Milkmonkey/Gem-925-Sterling-Silver-Paper-Clips/README.md

# Gem 925 Sterling Silver Paper Clips

工程试制文件位于 [silver_clip_jig_v02](silver_clip_jig_v02/README.md)。包括参数化OpenSCAD工装、打印STL、三维成品参考、弯折动作图、专利/原型审查与中文实物测试计划。

先运行 `bash silver_clip_jig_v02/source/install_tools.sh` 准备Python工具；OpenSCAD CLI在当前云环境已提供。按子目录README重建和验证。无需后台服务。

当前状态：CAD名义成形路径和导出网格已经检查；全硬银的回弹、开裂和夹纸能力尚未实测。尤其B/C额外过弯空间有限，必须先做试样，不能直接批量裁切十根银线。
