Milkmonkey/Gem-925-Sterling-Silver-Paper-Clips/silver_clip_jig_v02/README.md

# 925 银 Gem 手动弯线工装 V0.2

这是**可打印的工程试制版**：采用一根活动成形轴、三个可换衬套、一支三规格压弯杆和三个夹块，按 **A→B→C** 换销、重新定位。CAD 中的理想弯折动作与实际导出的网格有检查记录；尚未打印，也没有对用户的全硬银丝做材料试验，因此不能称为已验证的银回形针生产设备。

先看 [尺寸图](reference/gem_clip_dimensions.png)、[弯折过程](renders/bending_sequence.png)、[装配图](renders/assembly.png)、[爆炸图](renders/exploded_view.png)。完整限制见 [验证报告](validation/REPORT.md)，材料及夹纸验收见 [TEST_PLAN.md](TEST_PLAN.md)。

## 设计结论

成品初始外形为 **29.00 × 8.00 mm**，线径 1.00 mm。四段平行直线、三段半圆构成经典 Gem 拓扑。内圈顶弧中心高度取 19 mm，顶面约 21.25 mm，低于外圈内侧；这是为了让最后装入的完整 Ø6 mm C 销避开先成形的内圈，不是从专利图量取的尺寸。内圈较普通长舌款短，夹纸性能必须实测。

三道中心线半径 A/B/C = **1.75 / 2.50 / 3.50 mm**，金属芯轴直径 = **2.5 / 4 / 6 mm**。B、C 超出最初 2–3 mm 优先范围，是几何和可购买标准光杆的折中；三根同径销不能得到这套轮廓。孔与芯轴尺寸相差 0.20 mm，必须先打印公差片，不能把此数值当作已校准的 FDM 配合。

理论中心线展开长 **92.347 mm**，估计净银重 **0.751 g/枚**。该展开长度假定中性层在圆截面中心，没有塑性伸长；初次铜丝可留约 1 mm 总修端余量，再测量修正。未经试样标定，不应直接剪好十根银丝。

**关键材料限制：** 全硬银的可用延性、屈服强度和回弹均未获得供应商证据。小半径弯曲的名义外纤维应变很高（A 约 28.6%、B 20.0%、C 14.3%，仅作几何风险指标，不能直接代替延伸率判据）。B、C 又有有限的平面过弯空间；实测需要的补偿若超过验证报告的几何上限，本方案就不能按现有规格直接用于该线材。此时应停止银丝试制，另行评估扩大成品、改变材料状态等方案；不能强压、重复反弯或悄悄以退火银替代全硬银。

## 文件与打印

| 文件 | 数量 / 用途 |
|---|---|
| `stl/base.stl` | 1，95 × 75 × 10 mm 底座 |
| `stl/bending_lever.stl` | 1，119 × 16 × 8 mm，一支杆有 A/B/C 三组孔 |
| `stl/additional_parts.stl` | 一盘 7 个独立实体：3 衬套、3 夹块、公差片 |
| `stl/liner_A/B/C.stl` | 单独补打；与整盘重复，勿重复备料 |
| `stl/clamp_A/B/C.stl` | 单独补打；已翻到大平面贴床的打印朝向 |
| `stl/tolerance_coupon.stl` | Ø3.00、3.10、3.15、3.20、3.25 mm 孔，厚 3 mm |
| `reference/gem_clip_reference.step / .stl` | 三维成品参考，**不是工具零件** |
| `reference/gem_clip_centerline_1to1.svg` | 8 × 29 mm 的 1:1 轮廓；打印禁用自动缩放 |
| `reference/setup_A/B/C.svg` | 各工序已成形段的定位辅助图，1:1 打印 |
| `source/` | OpenSCAD、统一参数 JSON、重建及校验程序 |

PETG、0.4 mm 喷嘴、0.2 mm 层高、5–6 圈壁、50–60% 填充为初始设置。底座及杆按 STL 底面平放；衬套大法兰贴床；夹块 STL 已倒置打印，装配时翻回，垫高的压线舌在上。沉头螺钉必须齐平。小横向 M3 底孔约 2.6 mm，短跨桥接，不承诺所有切片设置均能免支撑；先检查切片预览，必要时用手钻清孔，不改变中心距。

底座插孔底面的法兰座为短悬边，先用公差片和一个衬套检查打印质量。孔不得强行敲入银丝接触用钢销。杆上压弯销的径向 M3 孔需要手动攻丝；优先用紧定螺钉，过度拧紧会损坏 PETG 螺纹。轴承不是必需件，但所有金属接触面必须去毛刺、抛光。保护膜若改变了有效直径，必须重新标定半径。

## 装配

1. 将底座固定在约 150 × 150 × 12 mm 的平整牺牲木板上。四个角孔 Ø4.5 mm，可用 M4×30 螺钉、垫圈和螺母；木板再夹到工作台。底座底面应有支承，衬套靠板面托住。木板在夹持螺钉对应位置预留约 Ø8 × 2 mm 凹窝，避免 M4×16 螺钉顶住板面。
2. 从底面放入当前 A/B/C 衬套，法兰 Ø12 × 2，筒身 Ø8 × 8；装好后顶面与底座齐平。换衬套时松开底座，向下推出，不要用银丝撬。其余衬套留在收纳区，不留在运动区域。
3. 从底面装入夹块用 M4 螺母。当前夹块放在轴中心左 14、下 10 mm 的螺钉处，用 **M4×16 沉头螺钉**固定，薄的平滑保护垫只用于接触面，厚度变化要重新调夹持高度。夹块不是剪线器，先在铜丝上证明不会滑移或压扁。
4. 放入当前 Ø2.5/4/6 × 40 mm 的光滑金属芯轴。轴底靠木板、插入深约 10 mm。下端倒角、上端去毛刺，不能用钻头刃部接触银丝。
5. 芯轴上装**金属轴限位环/钻深限位环**，其最低面离底座顶面 1.50 mm，上表面离底座顶面 9.50 mm。图示按高 8 mm、轴心外包络直径不大于 14 mm 计算。实际较矮的限位环可在其上垫光滑金属垫圈到同一高度，不能在底下放穿过线材平面的宽垫圈。锁定并检查与银丝顶面至少 0.50 mm 净隙。
6. 杆的对应 A/B/C 大孔套在芯轴上，杆底落在限位环上，距底座顶面 9.50 mm。选择同字母小孔，插入一根 **Ø3 × 25 mm 抛光钢销**，下端距底座顶面 0.15 mm。用杆侧 M3 紧定螺钉锁住；**其余两根压弯销不装**。杆只转动，不应向下压住银丝或夹块。
7. 桌面留出轴心约 120 mm 半径的手柄扫掠空间。先空转，再放铜丝检查；台钳、尺子、未使用的销轴都要移出。打印件强度与钢销强度没有经过实物载荷验证，勿加长手柄或敲击加载。

限位环提供高度支承，金属主轴提供旋转定位，底座夹块固定直段；这三项都需要，不能照 V0.1 仅凭手悬住压弯杆。

## 从直线到成品：A→B→C

以下数值来自**修平后的起点 P0**，不是多留余量后的毛坯端：P1=12.000，P2=17.498，P3=33.498，P4=41.352，P5=63.352，P6=74.347，P7=92.347 mm。用细记号笔标记，不刻伤线材。起点是内侧自由端，最后形成的外侧自由端是 P7。

三次操作均将当前**入弯直段从轴心下方向上送入，位于轴心左侧 R mm**；压弯销起于左侧，杆从左向上、向右**顺时针**转动。轴不是三道弯的空间坐标：每次要搬移、转向工件，让相应的 P1/P3/P5 对准同一根工作轴。

| 工序 | 装轴 / 夹块 / 杆孔 | 定位与固定 | 旋转及退件 |
|---|---|---|---|
| A | Ø2.5 / A / A | P1 到轴心水平线，入线中心 X=轴心−1.75；P0 在其下 12 mm；夹住下方直段。其余约 80 mm 为可动余料。 | 顺时针弯成顶部小 U。名义线材弯 180°；杆需加上约 13.09° 的接触空程，再加**实测允许**的回弹补偿。先拔压弯销、抬杆，松夹块，再整体向上拔出主轴和限位环，拿出工件。 |
| B | Ø4 / B / B | 将 A 工件转 180°；P3 对准轴心水平线，入线中心 X=轴心−2.50；夹住 A 后的 16 mm 直段中部，已弯 A 在轴心下方。 | 顺时针形成底部 U；杆名义约 191.97°。上一道 A 销已不在场；不得为了保持形状把它留在工件里。释放次序同 A。 |
| C | Ø6 / C / C | 工件恢复成品图方向；P5 对准轴心水平线，入线中心 X=轴心−3.50；夹住 22 mm 外侧直段。A、B 全部在工作轴下方，内圈顶端避开 C 销。 | 顺时针形成外圈顶弧；杆名义约 190.84°。最后外侧 18 mm 向右折下，压弯销在成品外侧。先向上拔压弯销和杆，再松夹块、拔 C 轴，成品可垂直抬走，无需掰开银丝。 |

表内杆角为理想无摩擦接触几何估计，包含 0.10 mm 径向游隙的几何接触空程，**不等于材料回弹补偿**。没有机械止挡，首次用纸质量角器和记号线逐步校准，不能只按杆角判定成品角度。`springback_compensation=0` 是尚未标定的初始值，不代表全硬银没有回弹。

每步都检查已弯部分没有被夹块碰到、当前销能拔出。过弯可导致自碰，尤其 B、C；见验证报告的实测采样界限并预留裕量。若银丝回弹无法在界限内补偿，停止该规格试制，不能将线段强行交叉或叠层后宣称合格。

## 校验与夹纸

底座右侧刻线只有测量用途，不参与承力，也不是卡死成品的凹模。标线内侧参考跨度为 29 与 8 mm，0.15 mm 线宽本身不作为精密量具；最终用游标卡尺测量。成品图起点、终点位于同一 Y=7 mm，三维参考初始共面。插纸时让内舌位于纸束一面、外圈位于另一面；仅把整枚金属线平放在纸上不会夹持。

本版没有擅自加入未验证的交叉、锤击或预扭。静态共面模型只能给出轮廓；接触预载与薄纸夹持需要实测。如 2 张纸即滑落，应记录并单独设计预载/空间微调，而不是凭图宣称功能成功。

## 重建与验证

在仓库根目录执行 `bash silver_clip_jig_v02/source/install_tools.sh`。环境已经安装 OpenSCAD 2021.01，安装脚本只准备 Python 工具；CAD/渲染依赖版本见 `source/requirements.txt`。

```bash
cd /workspace/Gem-925-Sterling-Silver-Paper-Clips/silver_clip_jig_v02
export XDG_CACHE_HOME=/tmp/silver-clip-cache
export MPLCONFIGDIR=/tmp/silver-clip-matplotlib
/workspace/.venvs/silver-clip/bin/python source/build.py
/workspace/.venvs/silver-clip/bin/python source/validate.py
/workspace/.venvs/silver-clip/bin/python source/design_review.py
```

默认参数入口为 `source/parameters.json`，重建先生成 `parameters.scad`，再调用 OpenSCAD 真正导出 STL；直接在 OpenSCAD 打开也可按 `part` 导出。JSON 改动不会自动重建。修改半径、线径、尺寸、芯轴/限位环高度后必须重新检查；SVG 定位图和 STL 也要一起重建。不要把多实体 `additional_parts.stl` 的 7 个零件当作一件粘合打印。

原型与专利资料存于 `reference/`，其审查见 [DESIGN_REVIEW.md](DESIGN_REVIEW.md)。设计目标成本、工装成本分列在 [BOM.md](BOM.md)，不声称当前银价已满足每枚 3 美元。
