Milkmonkey/Gem-925-Sterling-Silver-Paper-Clips/silver_clip_jig_v02/DESIGN_REVIEW.md

# 原型、专利与机构审查

## 已读资料

用户提供的 `silver_clip_jig_v01.zip` 已逐项解压并读取SCAD、STL、预览和装配说明，原样副本保存在 `reference/v01/`。专利网页为 https://patents.google.com/patent/US636272A/en ，原始PDF来自 https://patentimages.storage.googleapis.com/f8/2f/f3/f1428de641b1ff/US636272.pdf ，均实际下载；`reference/US636272.pdf` 和 `US636272-sheet2.png` 可离线查阅。正文文本也保存为 `US636272_text.txt`，其中OCR可能误把C识别为O，仍以扫描附图为准。

专利为William D. Middlebrook，US636272A，1899-11-07。已目视检查第二张图纸的Fig.5–8并对照说明书的工作过程，而非只参考搜索摘要。图不是比例尺寸图，本版半径均未从图中量取。

## Fig.5–8 的实际动作

| 附图 | 原机动作 | 对手动工装的启示 |
|---|---|---|
| Fig.5 | 线X经校直/送线、夹持及切断装置进入；夹杆36将线固定在C侧，A、B、C沿送线方向布置。上下面板F/D之间的窄缝约束线材平面；C销一侧有切除/凹槽，不是完整圆柱。 | 必须有独立夹持和明确的高度栈，不能只画三根柱。完整圆销C的包络要另外检查。 |
| Fig.6 | 齿条40驱动A弯绕器转动，偏置弯绕凸部绕中心销a形成第一弯。之后A下撤至面板D或以下，使已弯部分可进入下一动作。 | A成形后必须退出运动区域；人工拔销对应撤轴原理。 |
| Fig.7 | 齿条43驱动B弯绕凸部形成第二弯，随后凸部先下撤，中心销b短暂保留定位；中心销又由杆52上抽，杆48等机构对局部作永久定形。 | 旋转压弯件和中心定位销的退出是不同动作；不能把销留在闭合后的环里等最终硬拔。局部定形意味着原机也不是纯几何绕180°即可完成。 |
| Fig.8 | 滑台上的成形钳45/46绕C完成最后折弯，夹杆36仍保持线。末段由凸轮作用进一步压定；C随后下撤，钩57/滑块58带出成品，从床身孔59落下。 | 最终C处既要有保持，也要有退出路径。手动版用上拔金属销后整体提走，不能靠强行撑开成品。 |

原机的A/B转动、分时上下撤销、成形钳与辅助压定机构共同工作；不能认为原机已经验证了本版全硬925银的延性、回弹或夹持力。手动版采用分步搬移和同轴换销，也没有复制原机自动定形钳。

## V0.1 检查

两个原STL都是单个封闭网格，实测包络分别为42×80×8和65×15×9 mm；没有把“网格坏了”作为推翻原型的理由。问题在工艺与几何：

1. `station_pitch=18` 与29×8成品无推导关系，没有完整中心线路径与展开长度。
2. 三根Ø3销只能给约R2中心线半径，不能同时给本版三种所需圆弧。
3. 无明确的当前入线切点、夹持位置、送料坐标或初始长度；已弯部分如何避让不明确。
4. 原说明要求手悬杆于底座上方，缺少可靠高度支承；压弯销也没有明确轴向锁定。
5. 金属主销虽可拔，但没有给出每一步拔哪些销、先拔哪一个、最后怎么脱模的完整动作。
6. 没有成形阶段扫掠、全硬银最小半径/回弹数据、夹纸试验；文件自身也明确称为未经验证概念。

## V0.2 的取舍和被淘汰方案

本版将固定三工位改为**单轴换销**，每次仅一根金属主轴和一根金属压弯销存在；A/B/C是工序名及规格名，不是照搬18 mm空间间距。孔位、夹块和杆的接触距由目标中心线半径推得，夹持与上方限位环分担定位和高度保持。

初期尝试将A内圈顶弧靠近外圈顶部：完整Ø6 C销会占据已弯内圈。于是将A中心下移至Y=19 mm；现有理想模型中C销与既有线材净隙约0.755 mm。代价是内舌较短，功能是否合适待实测。

另试C→B→A，期望把最后小弯放在开放内区。实际中心线扫掠发现：先成形的C上弯挡住尚未成形的长余料，B在约146.25°首次出现**线材表面**接触，随后约156°出现中心线穿越；不能采用。`source/design_review.py` 可重复得到这一拒绝结果。后续A阶段仅是假设前序能完成的反例，没有把它统计为可执行工艺。

交付顺序A→B→C在理想无回弹0–180°过程可完成；最后C的杆与压弯销在成品外侧、所有宽支承位于线上方，拔压弯销→抬杆→松夹→拔主轴即可脱模。未用隐含“轴自动穿过银丝”解决干涉。

**仍未解决的材料相关限制是有限过弯空间。** A/B/C额外过弯的首次采样碰撞分别约11.85/1.80/3.25°。本版因此是铜丝动作及银丝半径试制工装，不是已经保证适配任意全硬925银的最终生产方案。完整银件试制以前，必须实测材料需求小于允许空间并留裕量；超出就应判该线材/几何组合NO-GO。未设计或宣称未经验证的自动出平面、加热退火、反复反弯可以解决它。

## 基本载荷估计的边界

取一个**假设**压弯/上轴承反力40 N、上轴承反力高度13.5 mm，将Ø2.5钢轴粗略当悬臂，弯曲正应力约352 MPa；假设钢E=200 GPa时挠度约0.086 mm。杆最窄腹板约0.94×8 mm，单纯平均剪应力约5.32 MPa；这不能代表孔边应力集中、层间性能或整体强度安全系数。

40 N不是已测银丝需求，也不是允许工作载荷。此估计说明应采用硬钢光杆、限制杆挠曲、避免宽松孔和蠕变，而不能宣称“PETG和任意廉价销足够强”。实际供销材料、打印层结合、夹持摩擦、限位环滑移均待验证，没有运行FEA或疲劳仿真。
