Milkmonkey/Gem-925-Sterling-Silver-Paper-Clips/silver_clip_jig_v02/validation/REPORT.md

# V0.2 验证记录

本报告针对交付的默认参数；原始机器可读结果见 `results.json`、`reference_brep.json`、`design_review.json` 和各个 `openscad_*.log`。参数修改后须重新运行程序并更新报告，不能把本次通过状态继承到新参数。

## 实际完成并通过的检查

| 检查 | 工具及证据 | 结果 |
|---|---|---|
| 专利正文与Fig.5–8 | HTTPS下载原PDF、HTML文本，目视第二张扫描图 | 已阅读；尺寸未照抄图片 |
| V0.1源文件与网格 | 实读SCAD/说明、Trimesh检查2个STL | 均封闭，尺寸42×80×8 / 65×15×9；缺口在机构与工艺 |
| 最终中心线路径 | 7个相切几何段、连续性断言、非相邻距离、Shapely无自交检查 | 连续、无自交，包络8×29 mm |
| 展开长度 | 解析直线+圆弧，对照1°采样弧长 | 92.347343 mm；采样92.347034，差0.000309 mm |
| 三维参考实体 | CadQuery 2.7.0 / OpenCascade 精确圆截面扫掠 | 有效BRep、单实体；另导出STEP和STL |
| 可打印零件实际导出 | OpenSCAD 2021.01 CLI，保存真实退出码和日志 | 10个工具STL导出成功，未忽略错误/警告 |
| STL闭合性 | Trimesh：watertight、绕序一致、正体积、逐实体检查 | 10个工具文件及1个参考STL通过；附加件盘7个独立实体，其余每文件1实体 |
| 实际孔位 | 从STL实取Z截面并测孔包络 | 底座主孔/夹持孔、杆6孔、衬套3内孔符合中心位置和孔径，约0.01 mm计算容差 |
| 打印朝向 | 检查每个独立实体最低Z=0 | 均落床；夹块大平面翻向打印床 |
| 名义成形动作 | A/B/C各0–180°，0.25°步长、每道721姿态 | 理想模型未发现已有线与活动圆弧/余料、固定线与压弯销、其它线与夹块、压弯销与夹块的碰撞 |
| 完整圆主销插入 | 当前芯轴圆包络与已成形路径距离 | B约1.623 mm，C约0.755 mm净隙；当前入线接触是预期约束 |
| 高度避让 | 线材顶1、限位环底1.5、杆底9.5、夹块顶5，均相对底座顶面 | 名义高度分离，主轴贯穿杆孔有足够长度；实际装配必须复核 |
| 反序方案反例 | `design_review.py` 另算C→B→A | B约146.25°开始线材表面碰撞；拒绝此方案 |
| 重复安装 | 再次执行 `install_tools.sh` | 固定版本依赖满足，实际CAD/网格/绘图库导入成功 |
| 图像输出 | Matplotlib Agg +真实三角面软件深度缓冲 | 尺寸、装配、爆炸与过程PNG实际生成；无需X服务 |

“11个STL文件”包含一盘附加件及其单独补打版本，不是11个不同工具零件。实际打印：底座1、杆1、衬套3、夹块3、公差片1，共9件。

## 名义动作的最小净隙

| 项目 | A | B | C |
|---|---:|---:|---:|
| 先成形线–活动余料表面 | 无先成形段 | 0.500 mm | 1.000 mm |
| 固定线–压弯销表面 | 0.182 mm | 0.216 mm | 0.261 mm |
| 其它线–夹块表面 | 2.350 mm | 2.350 mm | **0.350 mm** |
| 压弯销–夹块 | 7.509 mm | 7.519 mm | 7.500 mm |

压弯销与当前可动直尾的切触、芯轴与当前弯段的切触、夹块压在目标线材上都是有意接触，不按碰撞处理。0.35 mm间隙容易受FDM误差影响，实际打印必须量测；数值不是制造安全裕量。

## 过弯空间：未解决的工艺约束

在每道既有弯已理想成形为180°的前提下，以0.05°步长追加当前弯角，计算线材直径后的第一次自碰或夹具碰撞：

| 道次 | 最后一个未碰撞采样 | 第一个碰撞采样 |
|---|---:|---:|
| A | 11.80° | 11.85° |
| B | 1.75° | 1.80° |
| C | 3.20° | 3.25° |

这里保留的是**过弯角**；杆还有A13.09/B11.97/C10.84°接触空程。严禁混用两者。报告不把最后安全采样当作允许工作值，应预留实际线材、孔位、角度误差裕量。对全硬银，B/C可补偿量可能不足，因此不能宣称材料路线已验证。实测超过允许空间即NO-GO，具体顺序见 `TEST_PLAN.md`。

末步脱模是按高度分离与可拔销结构检查的运动方案：先向上拔Ø3压弯销，再抬杆、松夹块，最后向上抽出带限位环的C主轴，取出没有封闭扣环的开放线形。没有进行手接触、摩擦、拔出力或塑料孔夹紧的仿真，仍必须用铜丝实际确认。

## 强度与打印检查的范围

仅做基本数量级估计：假设40 N反力、13.5 mm钢轴悬臂高度，Ø2.5轴约352 MPa弯曲应力、0.086 mm挠度；最窄杆腹板的简单平均剪应力约5.32 MPa。这不是FEA、额定载荷、疲劳验证或PETG层间强度证明，硬件材质与实际需求未知。

零件按大平面落床设计；夹块已倒置避免鼻端底部悬空。底座底面衬套座的约2 mm局部悬边、小直径M3横孔，以及低于0.4 mm的浅刻细线仍需切片检查/必要清孔。没有安装切片器或打印机，未生成G-code，也未声称实体打印免支撑通过。精密定位用卡尺及1:1辅助图，不依赖喷嘴无法解析的细刻线。

初始图形渲染曾遇到VTK的X服务依赖失败，已替换为无X的CPU软件深度缓冲并实际生成成品图像；当前重建流程不依赖该失败路径。OpenSCAD导出仍使用真实CGAL实体运算，没有以图片或空文件替代STL。

## 待实体测试，不能宣称通过

银丝延性与表面裂纹、塑性中性层/真实下料长度、卸载半径与回弹、夹块摩擦/滑移、打印杆和限位环载荷能力、孔径制造误差、手动定位精度、2/5/10张夹纸及30次循环保持力、实际单枚成本。

扫掠为离散理想中心线计算，不是连续解析碰撞证明或全机构接触有限元。实际主轴间隙、材料横截面椭圆化、摩擦、出平面变形、人的操作误差均未模拟。判断“可试制”和“满足全硬银成品功能”必须分开。
