Milkmonkey/Gem-925-Sterling-Silver-Paper-Clips/silver_clip_jig_v02/reference/USER_BRIEF_zh.md

# Codex 工程任务：925 银 Gem 回形针手动成形模具 V0.2

## 一、项目背景与目标

我计划以低成本自行制作 10 枚经典 Gem 双圆弧回形针。

成品使用直径 1.0 mm 的全硬态 925 银圆线，外形参考普通 3# Gem 回形针。

由于数量过少，不考虑工业冲压、数控加工或金属激光切割。我希望利用家用 FDM 3D 打印机制作一套可重复使用的手动弯线模具。

此前已经制作了 V0.1 概念模型，但该模型只是初步结构探索，没有完成成品几何尺寸校准，也没有验证实际成形过程。

**本次任务不是简单修改原有模型，而是重新审查其机构合理性，完成具有实际可操作性的 V0.2 工程设计。**

## 二、参考资料

### 1. 历史专利

William D. Middlebrook：

*Machine for Making Wire Paper-Clips*

美国专利 US636272A，1899 年。

https://patents.google.com/patent/US636272A/en

重点分析专利 Fig.5、Fig.6、Fig.7、Fig.8。

这些图展示了金属丝在不同工位经过连续弯折形成 Gem 回形针的过程。

请阅读专利附图和文字描述，理解其中的：

- 弯折轴 A、B、C 的相对运动
- 绕线方向和弯折顺序
- 金属丝的定位与夹持
- 弯折轴的退出方式
- 不同阶段已经成形部分的避让
- 最终回形针如何从机构中脱离

不要求忠实复制整台自动化机器，而是提取适合手动操作的核心机械原理。

### 2. 现有文件

检查提供的 `silver_clip_jig_v01.zip`，其中包含：

- `silver_clip_jig_v01.scad`
- `silver_clip_base_v01.stl`
- `silver_clip_lever_v01.stl`
- `silver_clip_jig_preview.png`
- `README_assembly.txt`

将其作为参考原型，而不是正确的最终设计。

特别注意：

V0.1 中的 `station_pitch = 18` 只是未经验证的临时参数，不能直接认为适合 29 mm Gem 回形针。

必须重新建立成品几何和模具定位关系。

## 三、最终成品规格

| 参数 | 目标 |
|---|---|
| 造型 | 经典 Gem 双圆弧回形针 |
| 外形长度 | 约 29 mm |
| 外形宽度 | 约 8 mm |
| 线材 | 925 Sterling Silver |
| 线径 | 1.00 mm |
| 线材状态 | Full Hard，全硬态 |
| 数量 | 10 枚 |
| 单枚目标成本 | 不超过 3 美元 |

尺寸作为初步设计目标，可以根据真实 Gem 几何、金属丝截面和圆弧半径进行小幅调整，但必须说明调整原因。

最终产品需要具备实际夹纸功能，而不是仅用于展示的金属丝模型。

## 四、首要任务：重新建立 Gem 几何

不要直接设计模具。

首先建立一枚正确的经典 Gem 回形针的二维中心线路径。

需要包含：

1. 外侧轮廓。
2. 内侧弹性夹持线段。
3. 所有圆弧的中心位置及半径。
4. 线材起点与终点。
5. 每条直线段的长度。
6. 银丝理论展开长度。
7. 内外线段之间的自然间隙。
8. 可能产生接触或干涉的位置。

整个几何模型必须参数化。

至少开放以下参数：

```text
clip_length = 29.0
clip_width = 8.0
wire_diameter = 1.0

bend_radius_A = adjustable
bend_radius_B = adjustable
bend_radius_C = adjustable

inner_gap = adjustable
springback_compensation = adjustable
```

弯曲半径不能直接照抄专利图片。图片不是完整的现代尺寸工程图。

根据目标尺寸、银丝直径及全硬银丝的成形限制，建立合理的初始几何。

如果缺乏足够数据，明确区分工程假设和已经验证的参数。

输出成品的二维尺寸图及三维参考模型。

## 五、第二任务：确定实际弯折顺序

这是整个项目最重要的部分。

不要只制作三根固定的圆柱。

必须模拟从一根直银丝开始，依次完成全部弯折的实际操作。

对每个步骤分别明确：

- 当前银丝的形状
- 哪个位置需要固定
- 哪个位置需要旋转或压弯
- 施力方向
- 弯折的目标角度
- 是否需要超过目标角度以补偿回弹
- 已形成的结构是否会与模具干涉
- 定位销是否需要暂时拔出
- 能否顺利进入下一道工序

尤其要检查最后一道弯折。

不能出现理论轮廓正确，但实际无法完成最后一次弯折或无法取出成品的情况。

优先考虑以下机构：

**可拆卸金属销轴 + 3D 打印底座 + 旋转压弯杆。**

如果发现三工位结构不合理，可以改为多个独立工位，或者增加一个辅助夹持机构。

允许改变 V0.1 的布局。

要求优先保证真实机械可行性，而不是外观上类似历史专利。

## 六、第三任务：设计 3D 打印模具

### 6.1 底座

初步考虑：

- 尺寸约 60–100 mm × 50–80 mm
- 厚度约 8–12 mm
- 平面放置
- 圆角处理
- 预留金属销轴插孔
- 标注 A、B、C 成形工位
- 必要时增加起始定位挡块
- 必要时增加金属丝的临时固定结构

尺寸可以根据实际机械布局优化。

### 6.2 金属定位销

优先采用直径 2–3 mm 的光滑金属圆销。

金属销用于直接接触和支撑银丝，避免 3D 打印的小型塑料柱承受过大的局部载荷。

应支持拆卸、更换，以及按实际打印误差调整装配孔径。

如果需要不同半径的弯曲轴，可以设计可更换的销轴方案。

### 6.3 旋转压弯杆

尽可能设计一支可重复使用的手动压弯工具。

要求：

- 可围绕定位销旋转
- 具有合理的手柄长度
- 压弯点与定位轴之间保留银丝通道
- 减少银丝表面被刮伤的概率
- 允许操作者控制弯折角度
- 避免施力后打印件发生明显扭曲或开裂

压弯工具与银丝直接接触的部位，优先使用光滑金属销或可更换的保护部件。

如果单一旋转杆无法完成所有工序，可以设计可换向、可调整或多规格压弯组件。

### 6.4 成品校验区

希望在底座增加一个简单的成品校验区。

包含：

- 29 mm 长度参考
- 8 mm 宽度参考
- Gem 中心线轮廓参考
- 检查成品是否明显变形的定位结构

校验区不应妨碍弯折机构工作。

## 七、材料力学约束

目标线材为：

**1 mm 全硬态 925 银圆线。**

可采用以下初步材料参数：

```text
Elastic modulus: approximately 82 GPa
Density: approximately 10.36 g/cm³
```

实际屈服强度、延伸率和加工硬化状态必须根据供应商资料确定。

考虑以下问题：

1. 全硬态银线的剩余塑性变形能力较低。
2. 过小的弯曲半径可能导致表面开裂。
3. 全硬银线具有弹性回弹。
4. 反复弯折同一位置可能导致损伤。
5. 银线抗弯刚度与钢丝不同，最终夹持力未必相同。

不要假定 1 mm 全硬银线一定能成功制成普通 Gem 回形针。

建模时把弯曲半径和回弹补偿设为可调参数。

对于无法通过静态几何确定的材料问题，标记为需要实测验证。

不要通过缺乏依据的材料假设，宣称模具已经经过力学验证。

## 八、打印与制造要求

优先兼容普通 FDM 3D 打印机。

建议初始制造条件：

```text
Nozzle: 0.4 mm
Layer height: 0.2 mm
Material: PETG
Walls: 4–6
Infill: 40–60%
```

所有零件必须尽可能免支撑打印。

涉及金属销配合的孔应提供可调整公差。

对于关键装配，设计小型孔径公差测试件也可以接受。

不要将承担主要弯折载荷的细长金属销改成 3D 打印塑料柱。

不要求使用昂贵的五金件、轴承、线性导轨或特殊加工。

整个机构应该能够使用普通 3D 打印件、廉价标准圆销和简单手工具完成组装。

## 九、输出文件

优先使用 OpenSCAD 进行参数化设计，也可以使用 CadQuery，但必须提供可重新生成模型的源文件。

输出目录：

`silver_clip_jig_v02/`

至少包含：

```text
silver_clip_jig_v02/
├── source/
│   ├── silver_clip_jig_v02.scad
│   └── parameters.md
│
├── stl/
│   ├── base.stl
│   ├── bending_lever.stl
│   └── additional_parts.stl
│
├── reference/
│   ├── gem_clip_reference.svg
│   └── gem_clip_dimensions.png
│
├── renders/
│   ├── assembly.png
│   ├── exploded_view.png
│   └── bending_sequence.png
│
├── README.md
├── BOM.md
└── TEST_PLAN.md
```

如果实际设计不需要额外零件，可以省略 `additional_parts.stl`。

`bending_sequence.png` 应尽可能清楚地展示各个折弯阶段，也可以分成多张图片。

`README.md` 必须用中文编写。

物料清单至少注明各定位销规格、数量、建议长度，以及其他必要紧固件。

## 十、验证和验收

请在交付前完成以下检查：

### 几何检查

- 完整 Gem 轮廓是否在目标尺寸范围内
- 金属丝路径是否连续
- 是否存在不合理的线材自相交
- 是否准确计算展开长度
- 模具成形轴位置与目标回形针几何是否一致

### 机构检查

- 每一道弯折是否有合理的施力路径
- 旋转工具是否与其他定位销碰撞
- 已弯制的银丝是否阻碍后续操作
- 定位销能否在需要时移除
- 成品能否顺利脱模

### 模型检查

- 每个 STL 是否为封闭实体
- 是否有非流形几何
- 是否存在明显悬空或不可打印结构
- 重要孔位和装配间隙是否合理
- 模具结构是否具有足够的基本强度

如果可以运行 OpenSCAD CLI，请实际导出 STL，并检查是否成功。

如有合适的渲染或几何检查工具，实际执行检查，不要仅口头声称通过。

### 实物测试计划

需要提供一个明确的测试顺序：

1. 使用 1 mm 铜丝验证弯折动作和工装几何。
2. 使用少量全硬 925 银线进行弯曲半径测试。
3. 制作第一枚完整银回形针。
4. 测量成品长度、宽度与实际展开长度。
5. 进行 2、5、10 张纸的夹持测试。
6. 重复夹取 30 次，检查回弹、裂纹和永久变形。
7. 根据测试结果调整模型，再制作剩余九枚。

必须明确指出：铜丝能够验证成形动作，但不能替代银丝的力学性能测试。

## 十一、成本原则

最终目标为十枚实心 925 银回形针。

单枚成品目标成本不超过 3 美元。

3D 打印模具为可重复使用的工具，材料成本与模具制作成本分别统计。

尽可能减少银丝损耗。

不采用贵金属激光切割、银板加工、失蜡铸造等昂贵路线。

优先使用普通 FDM 打印技术和标准廉价零件。

## 十二、执行方式

请不要停留在方案讨论，也不要只输出文字建议。

直接进行工程建模与迭代：

1. 检查现有 V0.1 文件及专利。
2. 指出原模型存在的实际问题。
3. 构建参数化 Gem 回形针参考模型。
4. 规划完整弯折顺序。
5. 设计 V0.2 模具。
6. 导出能够打印的 STL。
7. 生成装配与操作示意图。
8. 检查打印可行性与几何干涉。
9. 编写中文组装说明和测试计划。

如果发现当前机械方案存在根本性干涉或无法完成弯折，请主动修改结构，不必机械地沿用 V0.1。

优先交付结构简单、容易制作、能实际操作的方案，而不是外观复杂的概念模型。

最终明确区分：

- 已通过 CAD 或代码验证的内容
- 基于工程假设设计的内容
- 必须等待实体打印和银丝试制才能确定的内容

**最终目标：一套低成本、可真实打印、可装配、可操作，并能用于试制 29 mm 经典 Gem 银回形针的手动弯线工装。**
