Milkmonkey/Gem-925-Sterling-Silver-Paper-Clips/silver_clip_jig_v02/reference/gem_clip_dimensions.png

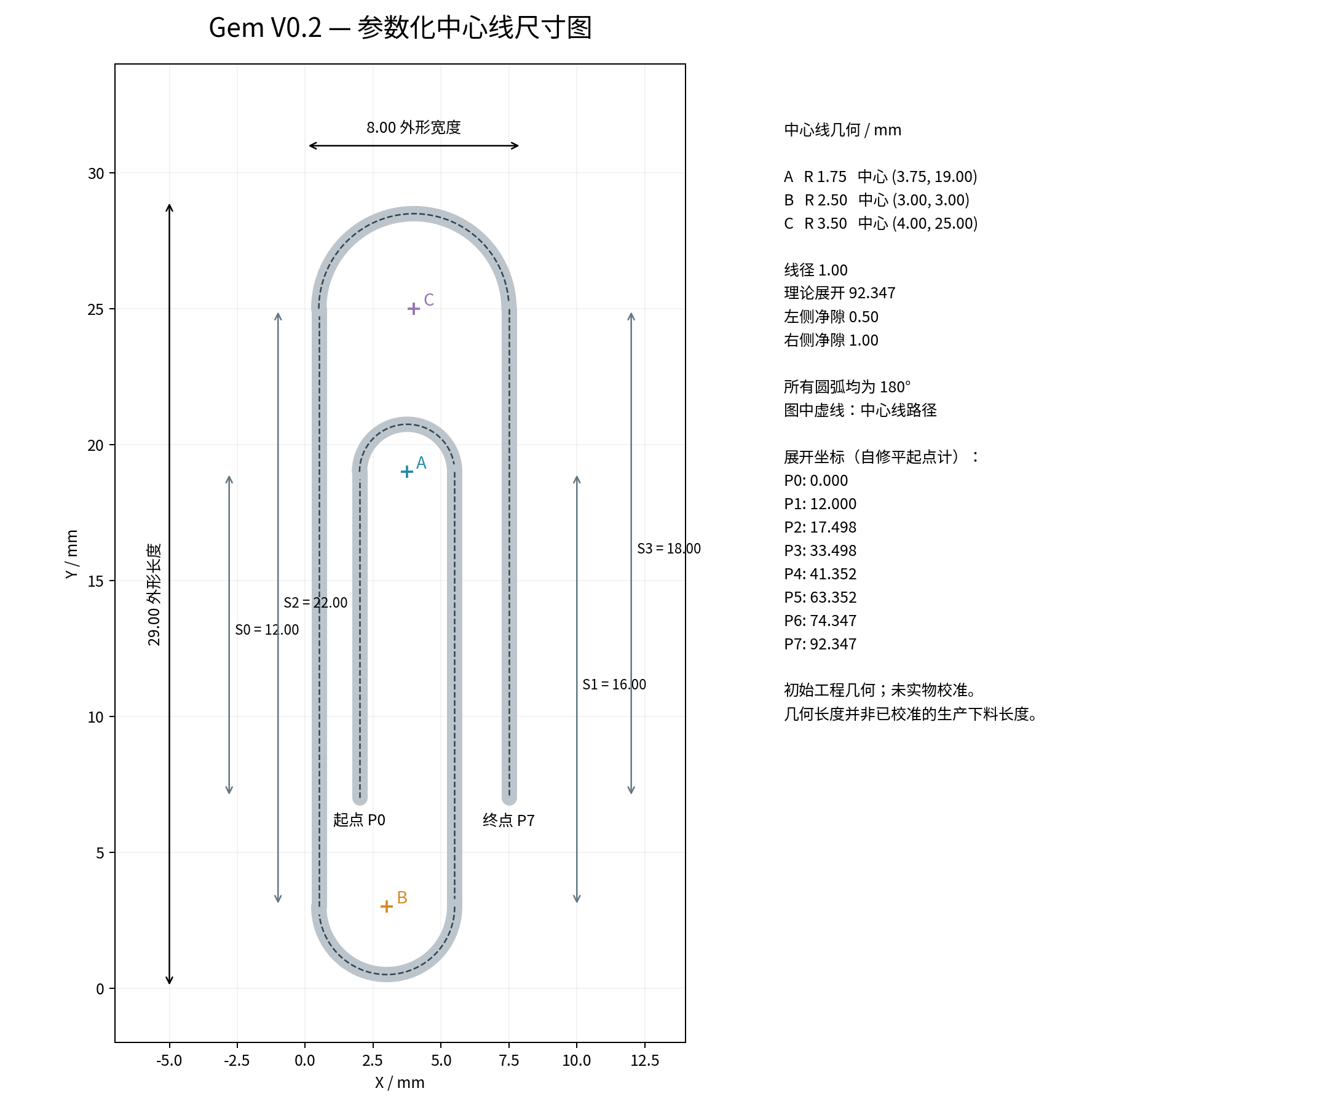
silver_clip_jig_v02/reference/gem_clip_dimensions.png
