Milkmonkey/Gem-925-Sterling-Silver-Paper-Clips/silver_clip_jig_v02/reference/US636272-figures5-8-inspection.png

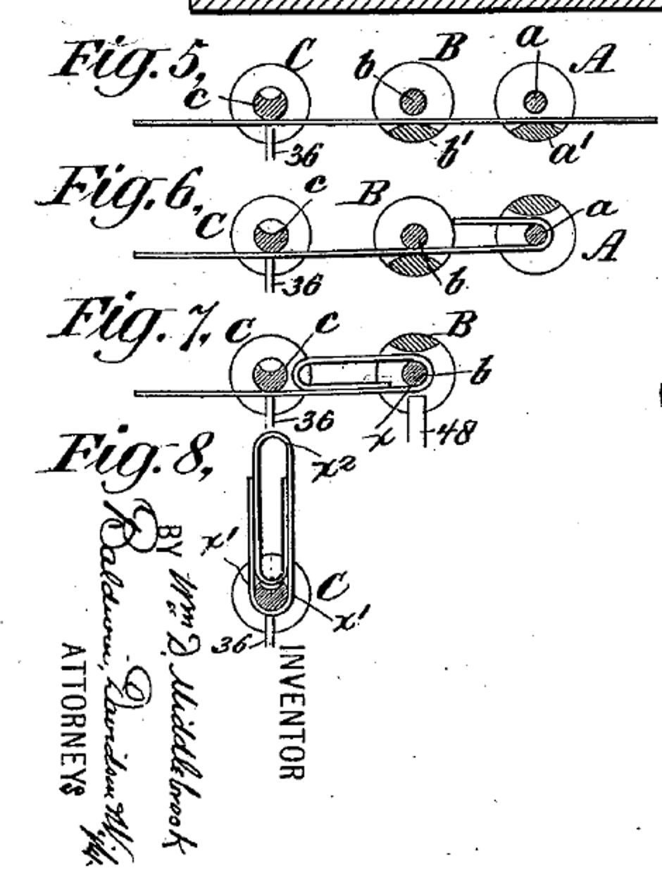
silver_clip_jig_v02/reference/US636272-figures5-8-inspection.png
