Milkmonkey/Gem-925-Sterling-Silver-Paper-Clips/silver_clip_jig_v02/reference/US636272-sheet2.png

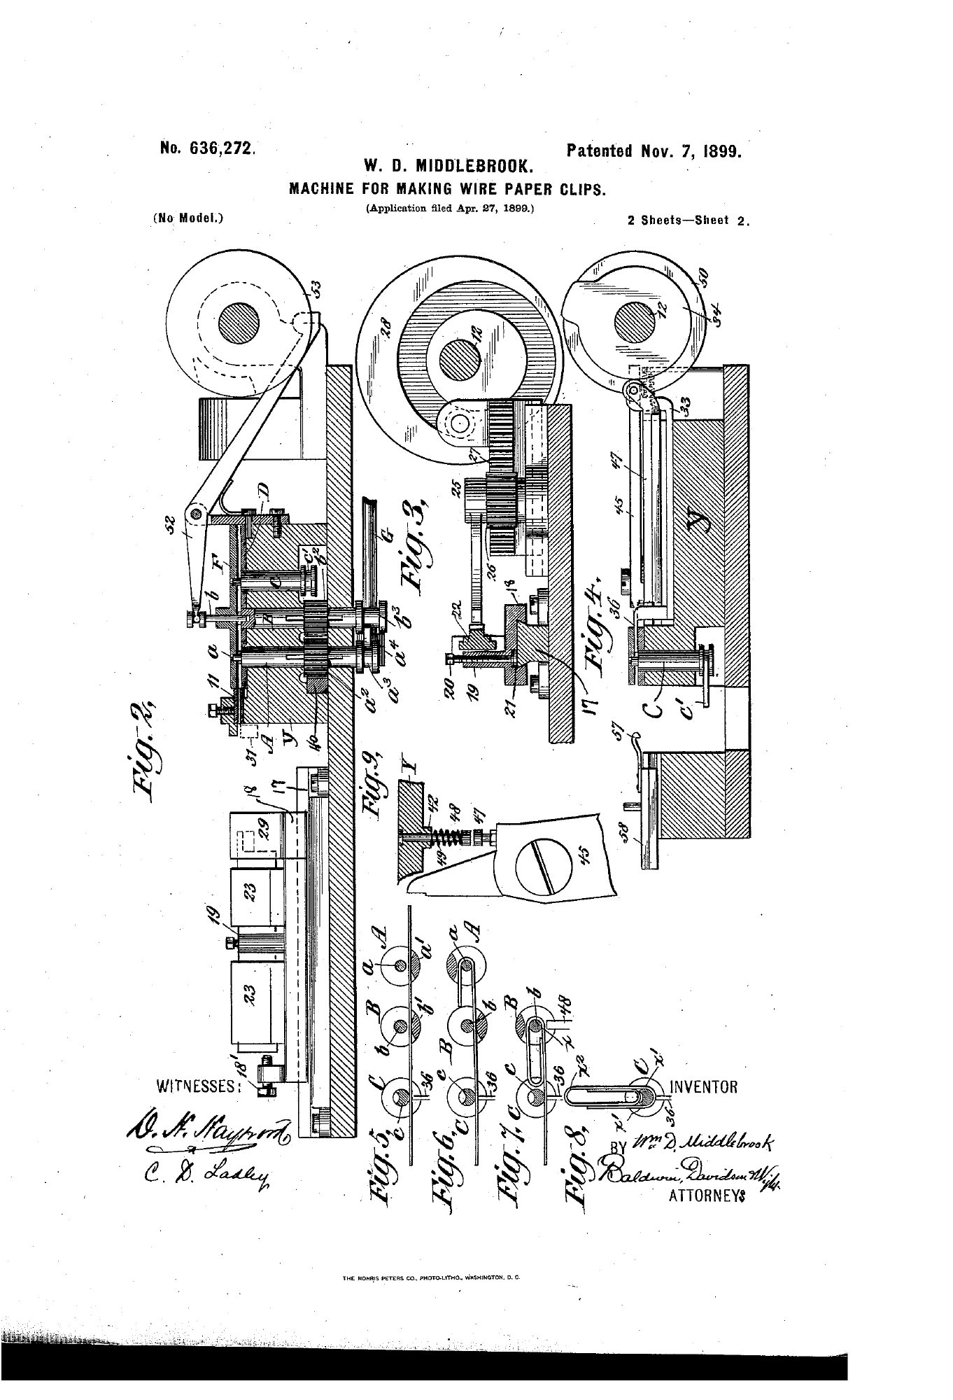
silver_clip_jig_v02/reference/US636272-sheet2.png
