Milkmonkey/Gem-925-Sterling-Silver-Paper-Clips/silver_clip_jig_v02/reference/v01/silver_clip_jig_preview.png

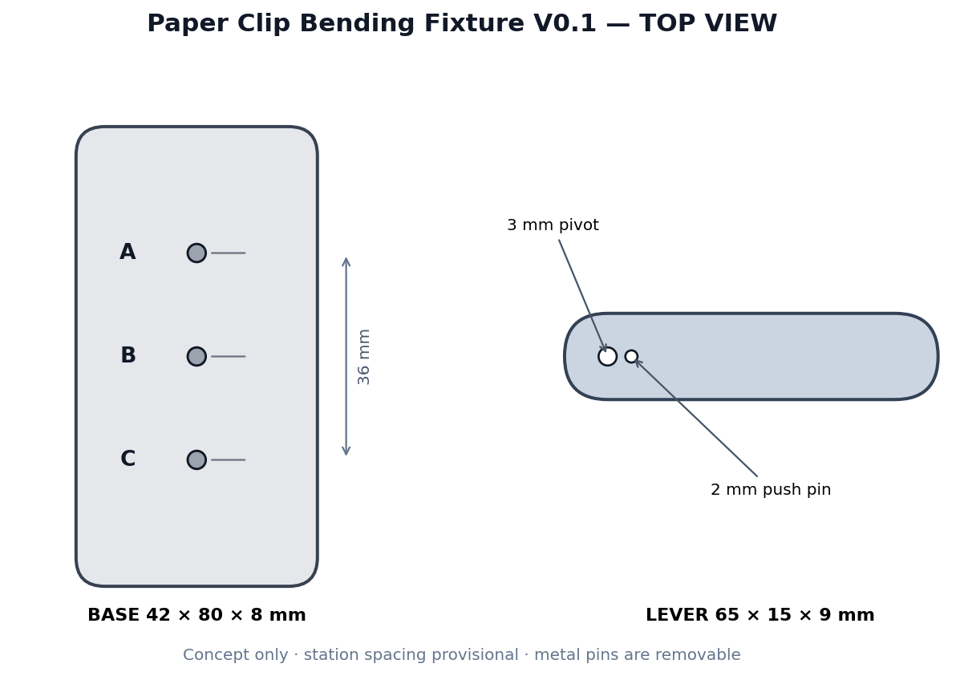
silver_clip_jig_v02/reference/v01/silver_clip_jig_preview.png
