Milkmonkey/Gem-925-Sterling-Silver-Paper-Clips/silver_clip_jig_v02/renders/bending_sequence.png

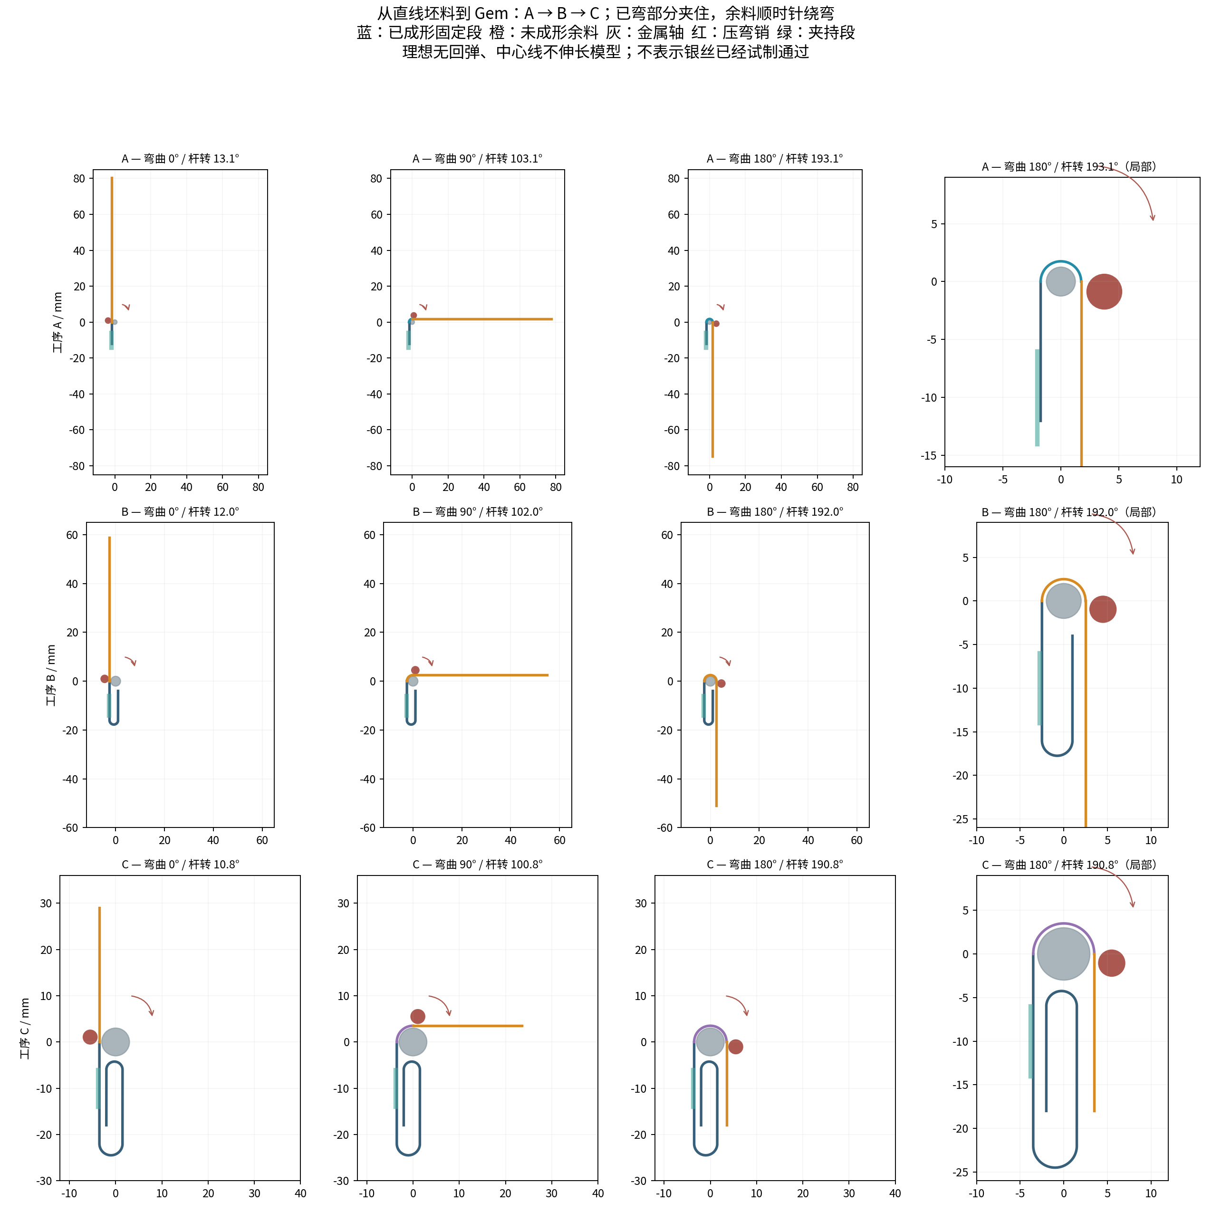
silver_clip_jig_v02/renders/bending_sequence.png
