Milkmonkey/Gem-925-Sterling-Silver-Paper-Clips/silver_clip_jig_v02/BOM.md

# 物料与成本

所有价格均为**预算栏/代数条件**，未查询或伪称实际采购报价。工具费用与银丝净成本分开；是否将人工、税费、运费和十枚试制损耗计入 3 美元目标，需要实际采购后核算。

## 可重复使用工具

| 物料 | 规格与数量 | 说明 |
|---|---|---|
| 打印底座 | 95 × 75 × 10 mm，1 | PETG，5–6 壁、50–60% 填充初始建议 |
| 打印压弯杆 | 119 × 16 × 8 mm，1 | A/B/C 三组大孔与压弯孔；只装一根压弯销 |
| 打印衬套 | 法兰 Ø12 × 2、外筒 Ø8 × 8，共 3 | A 内孔2.7、B 4.2、C 6.2；打印误差另测 |
| 打印夹块 | A/B/C 各1 | 沉头螺钉齐平；有薄垫时检查夹持高度 |
| 公差片 | 56 × 14 × 3 mm，1 | 可选先打，十分建议用于避免装配失败 |
| A 成形芯轴 | **Ø2.5 × 40 mm，1** | 光滑、抛光工具钢/硬钢圆销；廉价钻柄只能使用光杆部分，去锐边 |
| B 成形芯轴 | **Ø4 × 40 mm，1** | 可拔，不可压死在底座 |
| C 成形芯轴 | **Ø6 × 40 mm，1** | 圆销占据空间已按完整圆截面检查 |
| 压弯销 | **Ø3 × 25 mm，1** | 表面抛光、硬钢，三组孔换用；可另备1根 |
| 金属限位环 | 内孔匹配2.5/4/6 mm，各1 | 高8 mm或环+垫圈总高8 mm，轴心外包络 Ø≤14 mm。2.5 mm 环也可用合适钻深限位环，但偏心后仍需满足包络 |
| 紧定螺钉 | M3×6–8 mm，1–3 | 用于打印杆当前压弯销的径向锁定；先攻丝，不接触银丝 |
| 夹块螺钉 | **M4×16，90°沉头，1** | M4螺母1；不得突出杆扫掠平面；木板下面有避让凹窝 |
| 底座固定 | M4×30 圆头螺钉4、螺母4、垫圈8 | 适配约12 mm木板；实际厚度变化时重选长度，顶面头高≤5 mm |
| 平板/夹具 | 约150 × 150 × 12 mm牺牲木板1、台夹1–2 | 平面支承底座及贯通芯轴；板不能在轴底明显压陷 |
| 表面保护 | 极薄平滑PET膜或皮革小垫、可移除记号笔 | 压线处使用，不能用粗糙胶带缠轴后仍按原尺寸计算 |
| 通用手工具 | 卡尺、细锉、M3丝锥、孔径钻/铰刀、平口钳 | 可共用现有工具，无轴承、导轨、CNC件 |

最小杆头塑料腹板约 0.94 mm，两侧由整块 8 mm 厚杆体连接。仅有粗略载荷估计，见 `validation/design_review.json`；打印层结合、长期夹持蠕变和限位环锁紧均需实物检查。细销使用金属，不能以塑料杆替代。

## 银丝与成本边界

密度按用户给定 10.36 g/cm³；长度按理论中心线 92.347343 mm：

`m = π × (1/2)² × 92.347343 × 0.01036 = 0.751405 g/枚`

十枚净重约 **7.514 g**，净用线约 **923.47 mm**。例如单独预留 5% 生产损耗为约 969.65 mm、7.890 g，**不包括半径试样和失败件**。先用铜丝确定下料长度，再买/裁银丝。

令银线实付单价为 `p 美元/g`，每枚分摊修端/失败损耗为 `w g`，其它每枚耗材费用为 `c`：

`单枚材料成本 = p × (0.751405 + w) + c`

完全忽略损耗和其它费用时，要 ≤3 美元必须 `p ≤3.9925 美元/g`。若以5%损耗计且c=0，则 `p ≤3.8024 美元/g`。这只是预算上限，**不是银线市场报价或成本已达标的结论**。

填写实际预算时，另外统计：PETG实称质量×每克价格、四根钢销、限位环、螺钉、外协打印与运费。不能把工装和十枚银丝混合后声称银丝单价低，也不能将实心925银改成镀银线来满足预算。
