Milkmonkey/Gem-925-Sterling-Silver-Paper-Clips/silver_clip_jig_v02/reference/gem_clip_reference.step

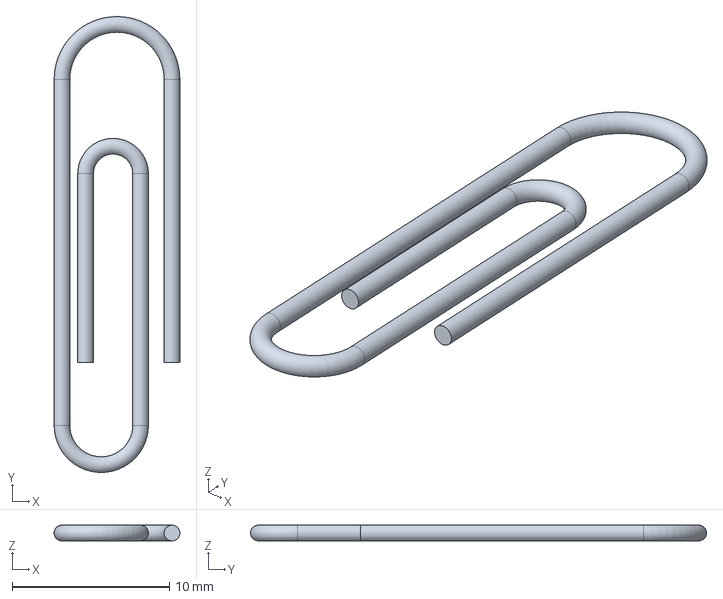
[picture p7: CAD file, 2026-10-22]
silver_clip_jig_v02/reference/gem_clip_reference.step
8.00 x 29.0 x 1 mm
