Milkmonkey/Gem-925-Sterling-Silver-Paper-Clips/silver_clip_jig_v02/reference/v01/silver_clip_lever_v01.stl

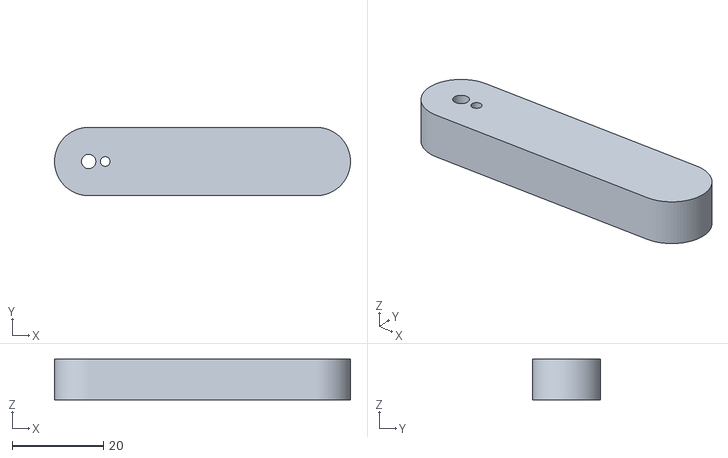
[picture p8: CAD file, 2026-10-22]
silver_clip_jig_v02/reference/v01/silver_clip_lever_v01.stl
65.0 x 15.0 x 9.00
