Milkmonkey/Gem-925-Sterling-Silver-Paper-Clips/silver_clip_jig_v02/stl/liner_B.stl

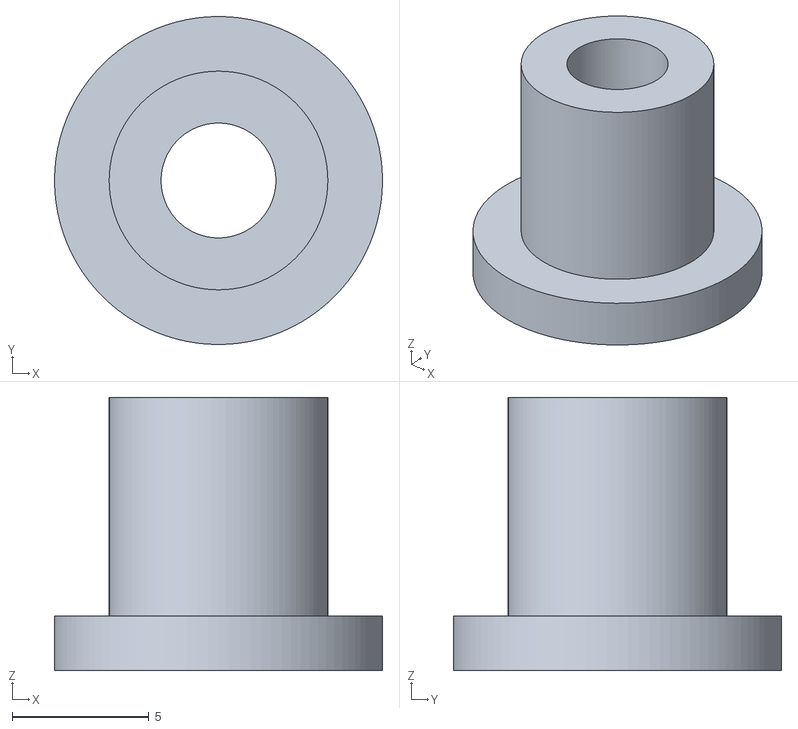
[picture p9: CAD file, 2026-10-22]
silver_clip_jig_v02/stl/liner_B.stl
12.0 x 12.0 x 10.0
