Milkmonkey/Gem-925-Sterling-Silver-Paper-Clips/silver_clip_jig_v02/reference/v01/silver_clip_base_v01.stl

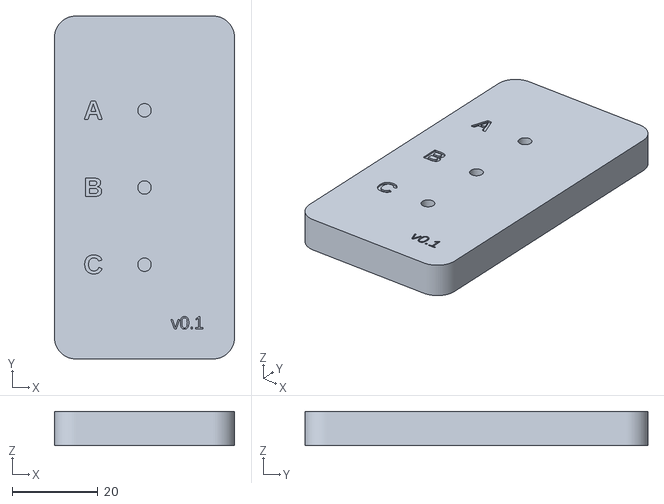
[picture p10: CAD file, 2026-10-22]
silver_clip_jig_v02/reference/v01/silver_clip_base_v01.stl
42.0 x 80.0 x 8.00
