Milkmonkey/Gem-925-Sterling-Silver-Paper-Clips/silver_clip_jig_v02/stl/clamp_C.stl

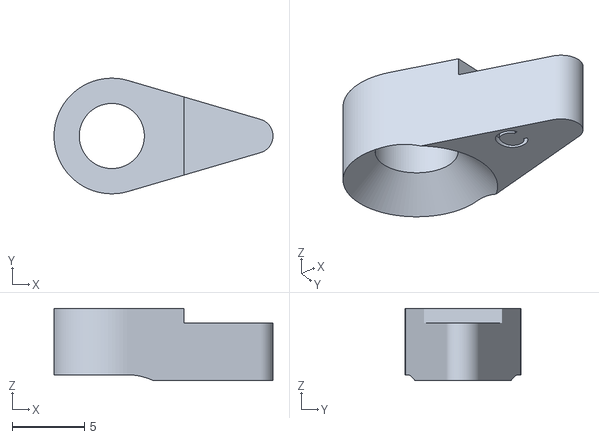
[picture p11: CAD file, 2026-10-22]
silver_clip_jig_v02/stl/clamp_C.stl
15.2 x 8.00 x 5.00
