Milkmonkey/Gem-925-Sterling-Silver-Paper-Clips/silver_clip_jig_v02/stl/base.stl

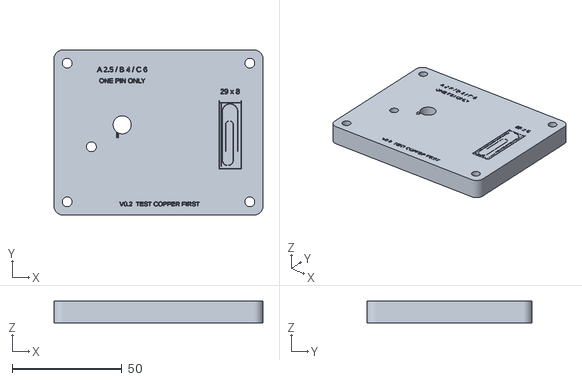
[picture p14: CAD file, 2026-10-22]
silver_clip_jig_v02/stl/base.stl
95.0 x 75.0 x 10.0
