Milkmonkey/Gem-925-Sterling-Silver-Paper-Clips/silver_clip_jig_v02/stl/bending_lever.stl

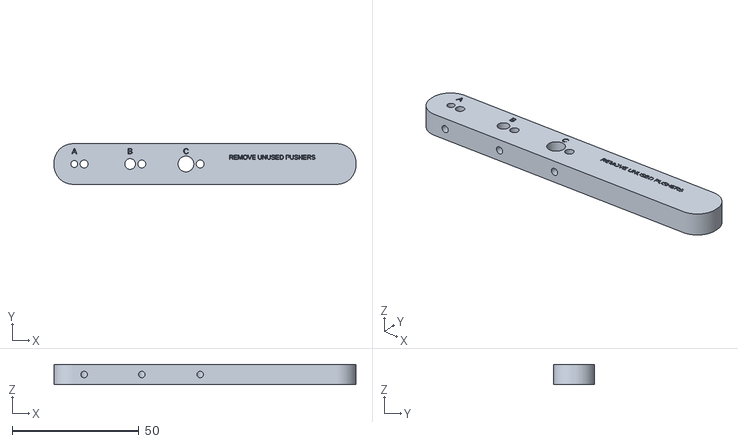
[picture p15: CAD file, 2026-10-22]
silver_clip_jig_v02/stl/bending_lever.stl
119.0 x 16.0 x 8.00
