Milkmonkey/Gem-925-Sterling-Silver-Paper-Clips/silver_clip_jig_v02/stl/additional_parts.stl

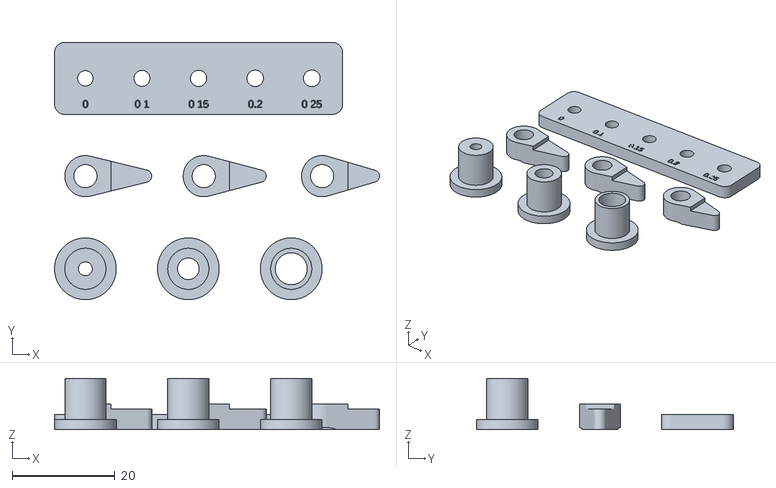
[picture p16: CAD file, 2026-10-22]
silver_clip_jig_v02/stl/additional_parts.stl
63.2 x 50.0 x 10.0
