Milkmonkey/Gem-925-Sterling-Silver-Paper-Clips/silver_clip_jig_v02/stl/liner_A.stl

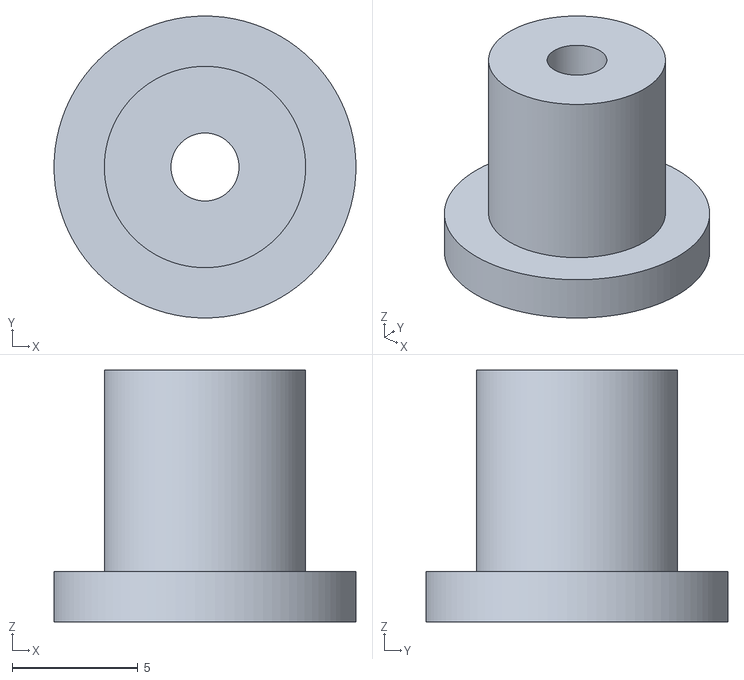
[picture p17: CAD file, 2026-10-22]
silver_clip_jig_v02/stl/liner_A.stl
12.0 x 12.0 x 10.0
