Milkmonkey/Gem-925-Sterling-Silver-Paper-Clips/silver_clip_jig_v02/stl/clamp_B.stl

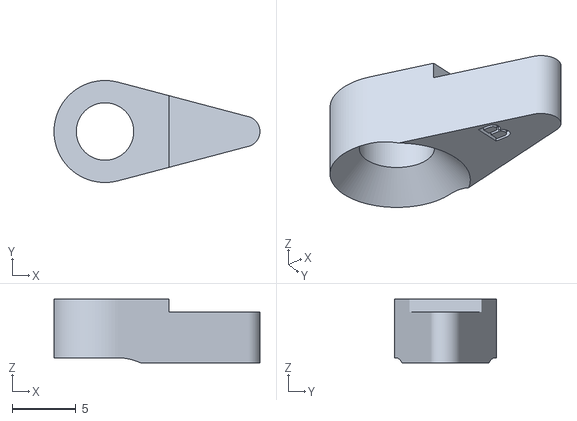
[picture p18: CAD file, 2026-10-22]
silver_clip_jig_v02/stl/clamp_B.stl
16.1 x 8.00 x 5.00
