Milkmonkey/Gem-925-Sterling-Silver-Paper-Clips/silver_clip_jig_v02/stl/tolerance_coupon.stl

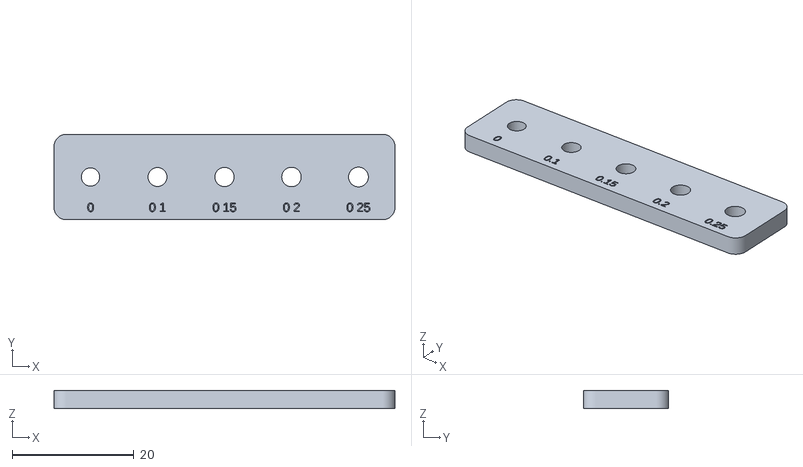
[picture p19: CAD file, 2026-10-22]
silver_clip_jig_v02/stl/tolerance_coupon.stl
56.0 x 14.0 x 3.00
