Milkmonkey/Gem-925-Sterling-Silver-Paper-Clips/(list of files, cad)

Other CAD files:
silver_clip_jig_v02/reference/gem_clip_reference.stl
