Milkmonkey/Gem-925-Sterling-Silver-Paper-Clips/silver_clip_jig_v02/TEST_PLAN.md

# 实物试制与验收计划

本表是**待执行计划**。云端几何检查不能替代任何一项实物测试。每次记录线材供应商、批号、直径、状态、打印材料、打印朝向、实际孔径、芯轴直径、每道弯曲加载角/卸载角及照片。禁止把铜丝试验结果当作全硬银的力学结果。

## 0. 材料与装配前置检查

向供应商取得925全硬线的批次资料：屈服/抗拉强度、延伸率、硬度或状态标准、最小建议弯曲半径、表面缺陷情况。缺失时标记未知，不能填入铜丝或退火银的数据。1 mm线径用卡尺/千分尺实测多个位置。

先打公差片与一只衬套，选择能手动插拔而没有明显晃动的孔；如改变孔余量，只改变配合孔，不擅自偏移中心。再打印底座、杆、三个夹块。夹块按STL朝向打印后翻回装配。检查层间裂纹、沉头齐平、台面支承和所有金属接触面的毛刺。

无载空转三组杆孔，检查120 mm周边净空、底座固定、压弯销锁定、主轴限位环不能滑下；银丝平面上方1.50 mm应无宽垫圈或塑料挡块。用1 mm直线铜丝检查压弯销下端0.15 mm高度确能接触线材，而不会刮底座。

## 1. 1 mm 铜丝动作试验

至少做2枚，直线坯料约93.35 mm，仅在最终外端留约1 mm修端余量；P0作为已修平参考端。按README标记各切点材料坐标，A→B→C，每步拍摄0/90/180°及卸载状态。记录：夹持是否滑动、杆是否扭曲、销是否上翘、夹块是否碰已弯部分、工具是否能退出。

每次换销前依次：拔压弯销→抬杆→松夹块→拔带限位环的主轴→拿工件。不得强拉工件跨过主轴，也不得把不用的销留在工作平面。最后C工序必须实际完成并完整脱模，铜丝不得靠剪断才能取出。

用卡尺测L、W、三个圆弧和所有直段；初始几何验收建议L=29±0.5、W=8±0.3 mm，后续用夹纸功能与工艺能力复核。此公差为试制建议，并非已量产保证。修端后记录实际坯长，和92.347 mm理论值比较，查明中性层位移/轴孔游隙/标记误差。铜丝只验证动作、定位与脱模，不能证明银丝不会开裂或有足够夹持力。

## 2. 少量全硬925银半径及回弹试样

在打印整套银件前，可先在独立试样上围绕抛光Ø6、Ø4、Ø2.5金属销，由大半径到小半径，每个半径用新的一段线。先小角度、再逐级增加到180°，每个试样同一弯位不反复反弯。记录加载角、卸载后角度、回弹、椭圆化、表面压痕；放大镜约10×检查外弧裂纹。

半圆试样局部需要至少约20 mm直臂以测角，试样长度及取样数量按供应商建议和余料预算单列，不能暗算在净用线内。发生裂纹立即停止该半径，不去做十枚完整银件。没有裂纹但回弹大的样本仍不能判定通过。

将每个半径的实测补偿与 `validation/results.json` 对照。该版本扫描到A约11.85°、B约1.80°、C约3.25°便出现几何碰撞；这些是碰撞边界，**不是允许的工作值**。建议至少留0.5°并同时留实际线材间隙裕量：B不高于约1.25°，C不高于约2.70°，A不高于约11.30°，且须用铜丝验证。若所需补偿超出任一道的允许范围，本版本对该银丝 **NO-GO**。不得用压弯杆跨过其它线段，或强行依赖线材自动扭出平面。

NO-GO后分别评估更大回形针、经用户确认的材料状态改变、具有可控空间避让/局部成形钳的新工装；这些不属于本版已经验证的能力。退火会改变“全硬”要求及最终弹性，不能仅退火后宣称满足原规格。

## 3. 首枚完整银回形针

只有半径和回弹均通过才剪第一根，按铜丝标定值留修端余量，记录实际质量。按A→B→C执行，逐步检查已弯外弧，不得为了追尺寸多次反弯。按实际回弹分别设A/B/C加载角，不把杆的几何接触空程当成材料补偿。

脱模后测L、W、线径变化、自由端位置、翘曲；修端圆滑。再次10×检查三个外弧与夹持处。先与底座刻线比对，再以卡尺为准。记录实际坯长与参考路径差异，不直接把误差全部归因于回弹。

## 4. 夹纸功能

用同批80 g/m²普通打印纸，记录实测纸厚，依次2、5、10张，每种重复至少3次。内舌与外圈分别在纸束两面，插入深度例如15 mm；记录插入力感、夹紧后自由间隙、纸面划痕、侧向滑移。

初始建议通过条件：竖直持纸束让夹子向下，在自重下30秒不脱落；以夹子支承相同纸束10秒不掉纸，不割纸；10张试验不出现不可恢复的张口。上述是可执行的初版用户功能标准，不能代替标准化保持力测试。可加弹簧秤记录缓慢拉出时的峰值，但不要事后只挑最大的数值。

## 5. 重复夹取30次

以5张同批纸完成30次完整插入/拔出，每10次记录外形及裂纹；结束后再跑2、5、10张测试。建议长度变化≤0.5 mm、宽度变化≤0.3 mm，无可见裂纹、无持续张口、保持能力无明显下降；如采用测力方法，可预先约定下降不超过20%。这些阈值是试制验收建议，需要用户实际用途确认。

## 6. 才决定其余九枚

保留首枚和失败件，建立尺寸/角度/成本记录。只有半径、回弹、脱模、夹纸和30次循环均达到预先标准，才按校准参数修改JSON、重新导出并验证CAD、再制作九枚。任何一项失败都应记录为失败，不用“外形相似”代替功能验收。

记录模板：

| 编号/线材批次 | 坯长/质量 | A/B/C加载角与卸载角 | L/W/翘曲 | 裂纹/压痕 | 2/5/10张 | 30次后变化 | 结论 |
|---|---|---|---|---|---|---|---|
| 待测 | | | | | | | |
